stopnoanime/microcomputer/stl/Lower.stl

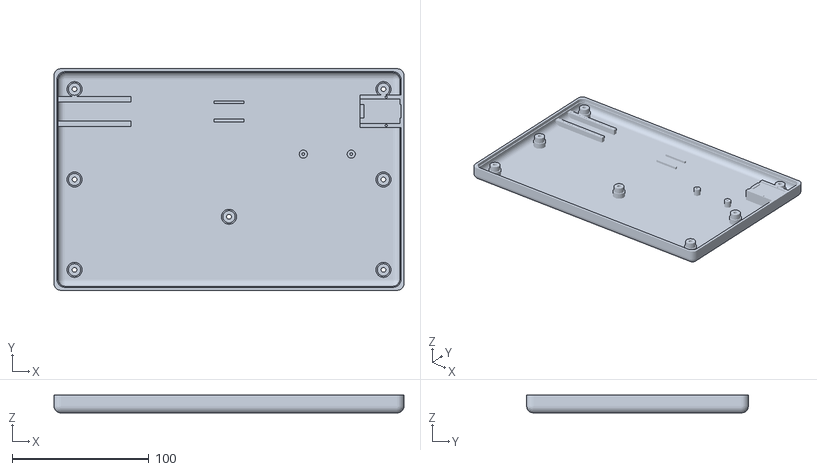
[picture p4: CAD file, 2022-12-02]
stl/Lower.stl
255.5 x 161.9 x 13.0
