stopnoanime/microcomputer/stl/Upper.stl

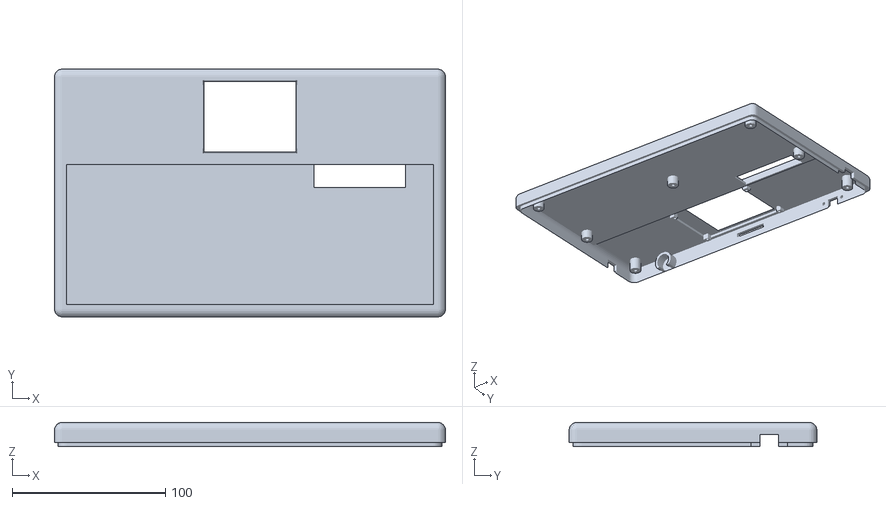
[picture p5: CAD file, 2022-12-02]
stl/Upper.stl
255.5 x 161.9 x 15.8
