stopnoanime/microcomputer/stl/Charger holder.stl

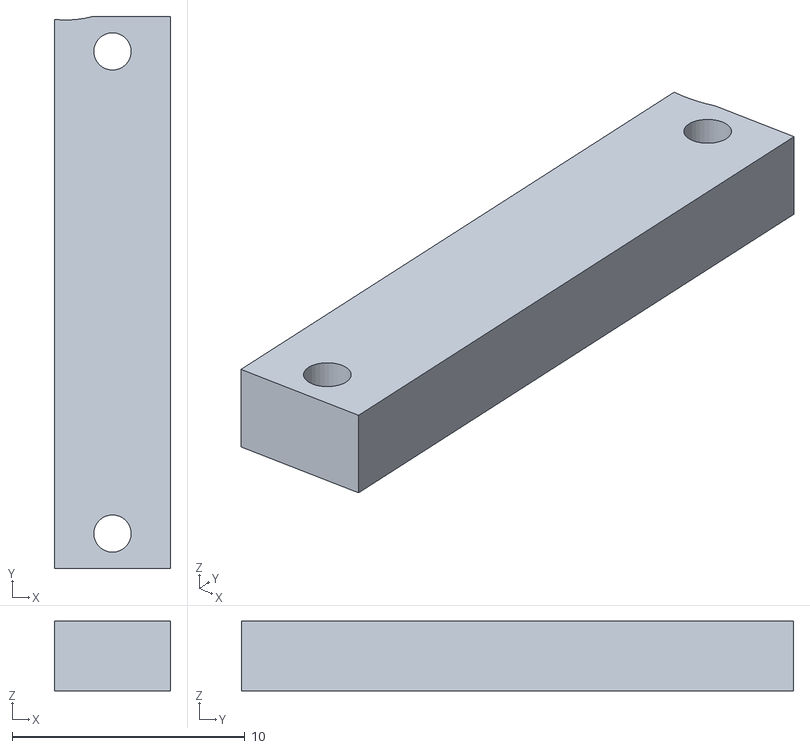
[picture p6: CAD file, 2022-12-02]
stl/Charger holder.stl
5.00 x 23.7 x 3.00
