stopnoanime/microcomputer/schematic/schematic.kicad_sch

## KiCad design schematic/schematic.kicad_sch (2022-12-02)

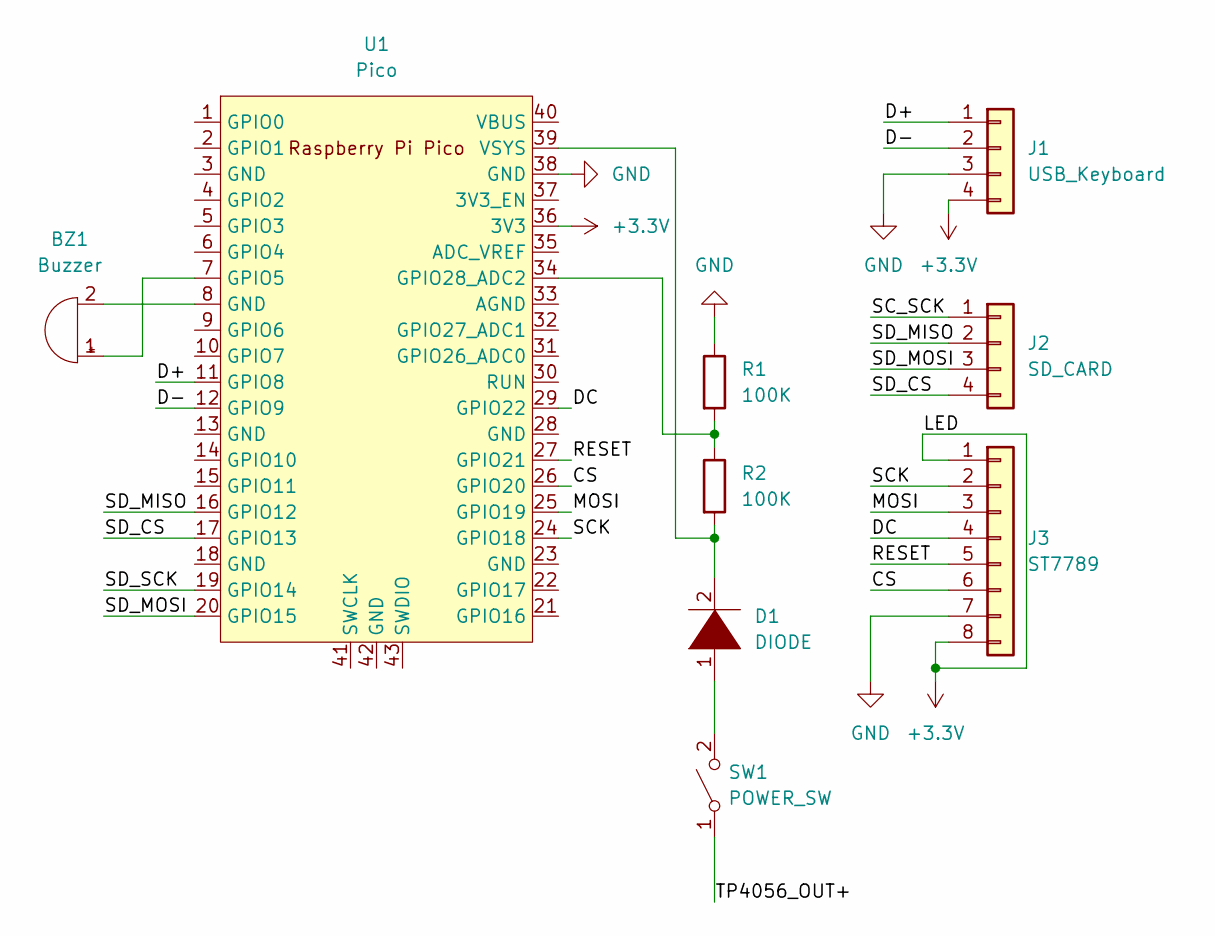
[picture p7: schematic schematic.kicad_sch]

Parts:
BZ1: Buzzer
D1: DIODE
J1: USB_Keyboard
J2: SD_CARD
J3: ST7789
R1, R2: 100K
SW1: POWER_SW
U1: Pico; RPi_Pico_SMD_TH

Connections:
+3.3V: J1.4, J3.1, J3.8, U1.36 (3V3)
CS: J3.6, U1.26 (GPIO20)
D+: J1.1, U1.11 (GPIO8)
D-: J1.2, U1.12 (GPIO9)
DC: J3.4, U1.29 (GPIO22)
GND: J1.3, J3.7, R1.1, U1.38 (GND)
MOSI: J3.3, U1.25 (GPIO19)
unnamed: BZ1.1 (-), U1.7 (GPIO5)
unnamed: BZ1.2 (+), U1.8 (GND)
unnamed: D1.1 (K), SW1.2 (B)
unnamed: D1.2 (A), R2.2, U1.39 (VSYS)
unnamed: R1.2, R2.1, U1.34 (GPIO28_ADC2)
RESET: J3.5, U1.27 (GPIO21)
SCK: J3.2, U1.24 (GPIO18)
SC_SCK: J2.1
SD_CS: J2.4, U1.17 (GPIO13)
SD_MISO: J2.2, U1.16 (GPIO12)
SD_MOSI: J2.3, U1.20 (GPIO15)
SD_SCK: U1.19 (GPIO14)
TP4056_OUT+: SW1.1 (A)
